Allouch-103/Abbes/report/main.pdf

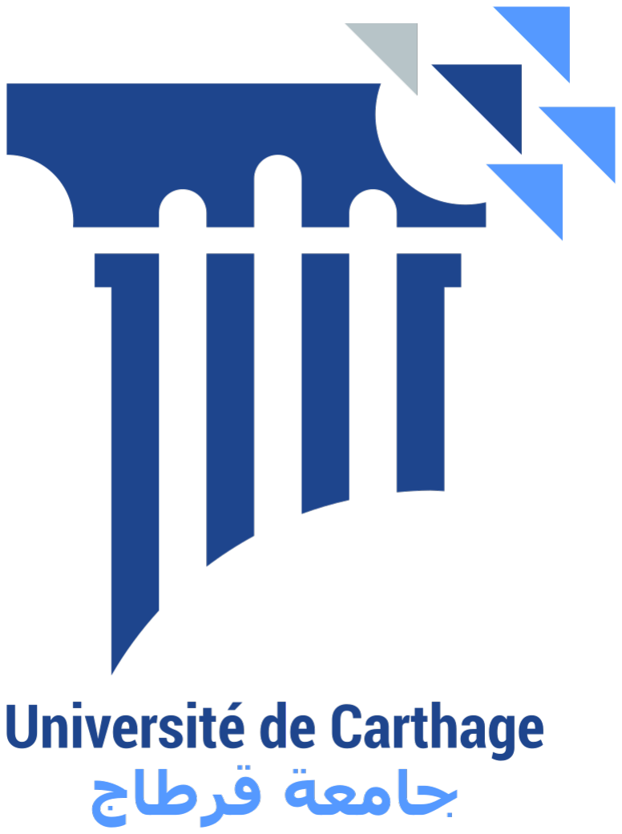
[picture p12: figure]
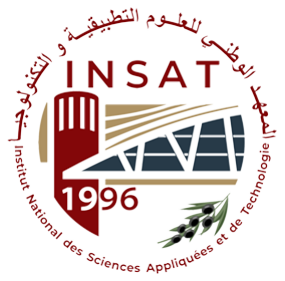
[picture p13: figure]

Ministry of Higher Education and Scientific Research
*** * ***
University of Carthage
*** * ***
National Institute
of Applied Science and
Technology

Projet Personnel Professionnel

Speciality: Software Engineering

Level: 3rd Year Engineering

Topic:

## Design and Software Architecture of an 18-DOF Humanoid Robot: ROS 2 Control, Simulation and an LLM-Based Natural-Language Command Layer

Prepared by:

### Zeyneb Benabdallah

### Yassine Allouch

Supervisor:

### Mme Hajer Taktak

Defended on 03/06/2026

### School Year: 2025 / 2026

# Acknowledgements

This work could not have been accomplished without the support and guidance of many people, to whom the authors wish to express their sincere gratitude.
The authors address their thanks first of all to their supervisor, Mme Hajer Taktak, for the trust she placed in them, for her guidance, her valuable advice and her availability throughout this project. Her insight greatly shaped both the technical direction and the quality of this work.
The authors also extend their gratitude to the members of the jury for the honour of agreeing to evaluate this project, as well as to the teaching staff of the National Institute of Applied Science and Technology (INSAT) for the knowledge shared throughout their studies.
Finally, the authors warmly thank their families and friends for their constant encouragement and unwavering support throughout this journey.

i

# Abstract

This report presents the design and software architecture of Abbes, a child-sized, 3D-printed humanoid robot with eighteen degrees of freedom (18-DOF). The platform is built end to end: from the mechanical CAD model and the electronics organised around an ESP32 micro-ros node, to a complete ROS 2 software stack that handles kinematics, balance and bipedal-gait generation. A Gazebo simulation provides a digital twin used for validation before deployment on the physical robot. Beyond the classical motioncontrol pipeline, the project introduces a high-level natural-language command layer: a locally hosted Large Language Model grounds free-form user instructions into a fixed, safety-checked command vocabulary that drives the robot’s actions. Particular emphasis is placed on the software engineering aspects of the system — the embedded firmware, the ROS 2 control architecture and the artificial-intelligence command pipeline — while the mechatronic and gait-planning foundations of the platform are also covered.

ii

# Contents

Acknowledgements | i
Abstract | ii
1 General Presentation and State of the Art | 1
2 Concepts on Bipedal Walking | 6
3 Hardware and Mechatronic Design | 11

iii

4 Embedded Firmware: the On-Board Controller | 17

iv

# List of Figures

1.1 WABIAN by Waseda | | 3
1.2 ASIMO | | 4
1.3 HRP humanoid robots | | 5
2.1 Motion planes: sagittal, horizontal, and frontal | | 7
2.2 General case of the ZMP: (a) three-dimensional case at the ankle, (b) planar case where the moment MAx is balanced by shifting the point of action of
the reaction force Rz | | 8
2.3 Support polygon in the single- and double-support phases | | 8

3.1 Anthropometric model: segment lengths as a proportion of total height H
(Winter’s model) | 12
3.2 Robot morphology: joint arrangement and reference frame (P: pitch, R:
roll, Y: yaw) | 13
3.3 Mechanical design of Abbes: (a) CAD model and (b) the 3D-printed, as-
sembled robot | 13
3.4 Electronic architecture of Abbes: the ESP32 micro-ROS node drives 18 servos through two PCA9685 boards and reads the MPU6050, communicating with the ROS 2 host over WiFi. Dashed red lines indicate power
distribution | 15

4.1 Firmware data paths: the command path (top) drives the servos at 100 Hz,
the sensing path (bottom) publishes the IMU at 50 Hz. Both periodic loops
run on the microcontroller’s clock | 18
4.2 micro-ROS bridges the microcontroller to the ROS 2 graph: a lightweight client on the ESP32 talks to an agent on the host, which connects it to the
full DDS network | 19
4.3 Agent-connection state machine, providing automatic reconnection without
rebooting the robot | 20

v

# List of Tables

1.1 Comparison of ASIMO Robot Models | | 3
1.2 Comparison of HRP Robot Models | | 4
1.3 Comparison of Bipedal Robots | | 5

3.1 Robot joint structure: axes, angular limits and resting positions (servo
degrees) | 14
3.2 Actuator specifications | 14
3.3 Sensor description | 15
3.4 Battery specifications | 15
3.5 Regulator specifications | 16

vi

# Chapter 1

# General Presentation and State of the Art

## 1.1 Introduction

Humanoid robotics is one of the most demanding fields of modern engineering: it combines mechanical design, real-time control, embedded electronics, and, increasingly, artificial intelligence into a single integrated system. Reproducing a behaviour as ordinary as human walking requires a machine to balance on a small support area while continuously coordinating many actuators, all under strict timing constraints. This makes a humanoid platform an ideal testbed for studying the interaction between low-level real-time control and high-level decision making.
This chapter introduces the project by outlining its objectives and its significance in the field of bipedal robotics. It then discusses the problematic aspects associated with bipedal walking, presents the state of the art through a few representative humanoid robots, and finally positions the Abbes robot — the platform developed in this work — with respect to those references. The objectives pursued are:
1. Design and assemble an 18-DOF humanoid structure from 3D-printed parts driven by hobby servo-motors.
2. Implement the on-board real-time firmware that actuates the joints and streams inertial measurements.
3. Build a modular ROS 2 software stack covering the kinematic model, balance control, and bipedal-gait generation.
4. Validate the robot in a physics-based simulation (digital twin) before deployment on hardware.
5. Add a natural-language command layer, based on a locally hosted Large Language Model, that translates free-form user requests into a fixed and safety-checked set of robot actions.

## 1.2 Problematic

Bipedal walking poses a unique set of challenges that stem from the need to maintain dynamic stability on two legs. For the platform developed here, these challenges are tightly coupled with the software-engineering goals of the project. The core problematic aspects are:

- Mechanical design. Defining a joint distribution that is rich enough to produce a stable, human-like gait while remaining buildable with low-cost, 3D-printed parts and hobby servo-motors.
- Control system. Despite the need for inverse kinematics in controlling a walking humanoid, ensuring robustness and adaptability in real-time control algorithms running on a resource-constrained microcontroller remains a significant challenge.
- Stability criteria. Keeping the robot balanced during the various phases of walking, which requires a recognised stability criterion and an inertial feedback loop.
- ROS 2 integration. Leveraging the advanced integration capabilities of ROS 2 to bridge a physics-based simulation and the physical robot through a common middleware.
- High-level interaction. Allowing a user to command the robot in natural language while guaranteeing that only safe, well-defined motions are ever executed.

## 1.3 State of the Art

Existing humanoid robots around the world showcase the remarkable advancements in robotics technology, demonstrating capabilities ranging from human-like motion and interaction to replacing humans in various industrial areas. The following sections review a few representative platforms.

### 1.3.1 WABIAN by Waseda

Since 1967, Waseda University has been at the forefront of biped-robot research. WABIAN-2 features 41 mechanical degrees of freedom, including two 6-DoF legs, a 2-DoF waist, a 2-DoF trunk, two 7-DoF arms, two 3-DoF hands, a 3-DoF neck, and two 1-DoF feet with passive toe joints. Standing at 1480 mm tall and weighing 64 kg, WABIAN-2 achieves a human-like gait characterised by stretched knees, heel-contact, and toe-off motion. This is made possible by its foot mechanism with passive toe joints and a 2-DoF (Roll, Yaw) waist that emulates human pelvic movement.

### 1.3.2 ASIMO by Honda

ASIMO is a research robot and is not available for commercial sale; it has, however, been loaned for unique events and used by major companies as a reception host. As of February 2009, there were over 100 ASIMO robots in various versions, ultimately aiming to assist individuals who are disabled, elderly, or ill, and to perform tasks that are dangerous for humans. The fifth version of ASIMO, released in September 2011, features enhanced capabilities including the use of all its fingers, equipped with tactile sensors in the palm and force detectors in each finger; combined with object-recognition technology, it can pick up a bottle and unscrew its cap, or hold a paper cup without crushing it. One of its main innovations is the ability to change direction smoothly while walking, without interrupting its stride.


Figure 1.1: WABIAN by Waseda.

Table 1.1: Comparison of ASIMO Robot Models.

Project | Date | Weight Length Anatomy | Functions | DoF DoF Head
P-1 | 1993–1997 175 kg | 1.915 m Head, Arm, Hand,
Leg, Feet, Trunk
Walking | – | –
P-2 | – | 210 kg | 1.82 m | – | Walking, Climbing
stairs
30 | –
P-3 | – | 52 kg | 1.2 m | – | Speed | walking
| | | | | (1.6 km/h)
26 | –
Asimo I | 2000 | 54 kg | 1.3 m | – | Speed | walking
| | | | | (3 km/h), | Object
| | | | | detection, | Face
| | | | | recognition
34 | 3
Asimo II | 2005 | 54 kg | 1.3 m | – | Running (6 km/h), Gripping objects
34 | 3
Asimo III 2011 | 48 kg | 1.3 m | – | Human daily tasks,
Collision | avoid-
ance, | Dynamic
| | | | | path planning
57 | 3

### 1.3.3 HRP Humanoid Series by AIST

The Humanoid Robotics Project (HRP) is an initiative aimed at developing general domestic-helper robots, funded by Japan’s Ministry of Economy, Trade and Industry (METI) and the New Energy and Industrial Technology Development Organization (NEDO). The project is led by Kawada Industries with support from the National Institute of Advanced Industrial Science and Technology (AIST) and Kawasaki Heavy Industries. The HRP series, also known as Promet, began with modifications to Honda’s P3 robots and includes features such as a tele-command system. Notably, HRP-2 can stand up after lying flat, a capability lacking in Honda’s ASIMO. The HRP-4, a bipedal humanoid, stands 150 cm tall and weighs 39 kg.

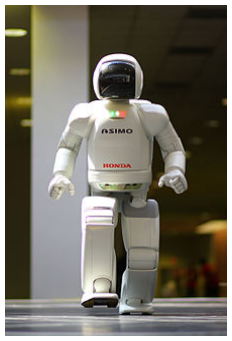
[picture p14: figure]

Figure 1.2: ASIMO.

Table 1.2: Comparison of HRP Robot Models.

Project Date Weight Length Anatomy | Functions | DoF DoF Head | DoF Arm | DoF Leg
HRP-1 | 1998 | 120 kg | 1.6 m | Head, | Trunk,
| | | | Arm, | Hand,
Leg, Feet
Walking | /
Hand | opera-
tions
30 | 2 | 14: 3 shoulders,
1 elbow, 3 wrist

12

HRP-2 | 2003 | 58 kg | 1.54 m | – | Walking on rug,
Standing, | Hu-
| | | | | man interaction
30 | 2 | 12: 3 shoulders,
1 elbow, 2 wrist

12

HRP-3 | 2007 | 65 kg | 1.6 m | – | Speed walking 2 km/h
42 | 2 | 12: 3 shoulders,
1 elbow, 2 wrist

12

HRP-4C 2009 | 43 kg | 1.58 m | – | Anthropomorphic,
Face | expres-
| | | | | sions
42 | 11: | 3 neck, 8
face
4 | 12
HRP-4 | 2010 | 39 kg | 1.51 m | – | Athleticism, Running, Oper- ating tasks
34 | 2 | 4 | 12

### 1.3.4 Positioning of Abbes

The platforms above achieve outstanding performance but rely on custom, expensive hardware that is out of reach for a student project. Abbes is positioned instead as a low-cost, fully 3D-printed, 18-DOF humanoid built around hobby servo-motors and an ESP32 microcontroller. Its distinguishing contribution is not raw locomotion performance but its software: a modern ROS 2 control stack with a physics-based digital twin, and a natural-language command layer driven by a locally hosted Large Language Model — a feature uncommon on platforms of this scale, and the main software-engineering contribution of this work.

## 1.4 Conclusion

This chapter explored the fundamental principles and obstacles within bipedal robotics. By examining both the challenges and the state-of-the-art developments, it identified the critical focal points for the project. The subsequent chapters delve into the specific methodologies, design considerations, and practical implementations required to build the robot. Table 1.3 provides a concise overview of the key features of the robots studied above.


(a) HRP-1 | (b) HRP-2

Figure 1.3: HRP humanoid robots.

Table 1.3: Comparison of Bipedal Robots.

Robot | Height (mm) Number of DoF | Capabilities and Features
WABIAN by Waseda | 1480 | 41 | Human-like gait, stretched knees, heel-contact, toe-off motion
ASIMO by Honda | Varies | Varies | Bipedal locomotion, object ma- nipulation, human interaction
HRP Series by AIST | Varies | Varies | Anthropomorphic design, various locomotion modes

# Chapter 2

# Concepts on Bipedal Walking

## 2.1 Introduction

Bipedal walking, or walking on two legs, is a complex form of locomotion that involves the coordination of multiple joints to achieve stability, balance, and forward motion. Understanding its principles is essential for designing and controlling a humanoid robot. This chapter introduces the fundamental concepts of bipedal walking: the definition of walking, the motion planes, the centre of mass, the Zero-Moment-Point, the support polygon, the stability criteria, the types of walking, and the gait cycle that together underpin the locomotion work presented later in this report.

## 2.2 Walking Definition

Walking can be defined as the action of moving by successive movements and support of the legs and feet without ever leaving the ground entirely. This definition does not constrain the number of limbs, so walking may be bipedal, quadrupedal, and so on; in this work the term refers to bipedal walking, since the objective is to reproduce human locomotion. Walking is therefore a cyclic phenomenon: each foot alternately swings through the air and then serves as support, either alone or together with the other foot. This cyclic nature is formalised through the notion of gait cycles and phases, developed in the following sections.

## 2.3 Motion Planes

The motion planes describe the movements associated with walking, as shown in Figure 2.1. The sagittal plane corresponds to a side view of the walker, the horizontal plane to a top view, and the frontal plane to a front view. The walker moves primarily in the sagittal plane, but movements such as hip sway, lateral displacement, and pelvic rotation occur in the other two planes and enhance the fluidity of walking.

## 2.4 Robot Control and Stability

Bipedal walking relies on several key concepts that ensure stability and efficiency. These concepts are essential for understanding how to design and control a bipedal robot.

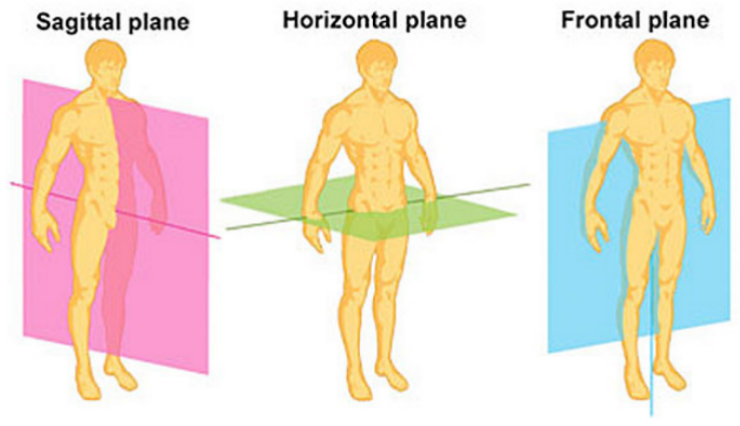
[picture p15: figure]

Figure 2.1: Motion planes: sagittal, horizontal, and frontal.

### 2.4.1 Centre of Mass (CoM)

The centre of mass (CoM), also known as the centre of gravity, is the point at which the mass of a body or system of bodies can be considered to be concentrated. For a rigid body, it is the point at which the body can be balanced without rotation under the influence of gravity alone. Mathematically, it is the weighted average of the positions of all the mass elements of the system. The CoM plays a central role in the study of the mechanics, dynamics, and stability of a walking robot.

### 2.4.2 Zero-Moment-Point (ZMP)

The Zero-Moment-Point (ZMP) is a criterion used to analyse the stability of a bipedal or multi-legged robot during dynamic motion. The ZMP is the point on the ground where the total moment of the forces acting on the robot’s feet has no horizontal component — that is, the point where the ground-reaction forces and the inertial forces acting on the robot’s body balance each other out.
Consider the support foot during the single-support phase (Figure 2.2). The effect of the parts above the support foot can be replaced by a force F and a moment MA at the ankle, while the ground reaction R and moment MS balance the system at the contact point S. Because the ground can only act on the foot through friction and a normal force, the horizontal moments vanish at this point — hence the term Zero-Moment-Point. The ZMP is thus the point under the foot where the ground reaction balances the horizontal moments applied at the ankle. To maintain dynamic balance, the ZMP must remain inside the support polygon; if the support area is too small to compensate the horizontal moment, the robot loses dynamic balance and the ZMP is no longer defined (a fictitious ZMP may then be computed for analysis).

### 2.4.3 Support Polygon

The support polygon is one of the stability criteria for humanoid walking. It is defined by the outer contour of the points of contact between the robot’s feet and the ground. As

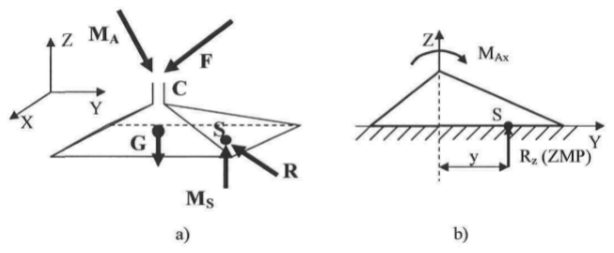
[picture p16: figure]

Figure 2.2: General case of the ZMP: (a) three-dimensional case at the ankle, (b) planar case where the moment MAx is balanced by shifting the point of action of the reaction force Rz.

illustrated in Figure 2.3, it takes two forms during the walking cycle: the single-support polygon, reduced to the contour of a single foot, and the larger double-support polygon, spanning both feet when they are simultaneously in contact with the ground.


Figure 2.3: Support polygon in the single- and double-support phases.

### 2.4.4 Stability Criteria

Two complementary aspects of stability are considered:
- Posture stability — the ability to maintain a stable standing position with minimal jerk. Joint positions and the centre of gravity are the main variables involved.
- Gait stability — the ability to maintain balance during locomotion. The key variables here are step length, foothold positions, and ZMP data.

## 2.5 Types of Bipedal Walking

Walking can be categorised into two types:

- Static walking. The posture is stable at all times: the body weight is always supported by at least one foot, and the projection of the CoM on the ground always remains within the support polygon.
- Dynamic walking. A succession of stable and unstable postures. Instability is deliberately created forward when the projection of the CoM moves outside the support polygon. Dynamic walking is the natural human gait; the resulting instability is corrected by the next step.

## 2.6 Robot Gait Generation

### 2.6.1 Walking-Cycle Components

Ignoring the very first and very last steps to and from a standing posture, the walking cycle is composed of two alternating phases:
Double-Support Phase (DSP) The robot is in contact with the floor through both legs. This phase lets the robot shift its ZMP into a favourable position for the next step without losing balance; it is therefore called the stabilisation phase.

Single-Support Phase (SSP) Also known as the swing phase, the robot is in contact with the floor through a single leg. The leg in contact is the support leg and the other is the swinging leg.

### 2.6.2 Walking-Cycle Phases

Within these components, the cycle progresses through the following phases:
- Impact / contact phase (DSP) — the heel of the front foot comes into contact with the floor.
- Lift-off / swing phase (SSP) — during the transition from double to single support, the swinging foot is lifted off the ground; the robot transfers its weight onto the support foot and starts swinging the rear leg forward.
- Catch phase (DSP) — the swinging foot comes back into contact with the floor, returning the robot to double support.
The roles of the two legs are then swapped and the cycle repeats.

### 2.6.3 Gait Engine

The gait engine, also referred to as the walking-pattern generator, is the software component responsible for producing a sequence of feasible joint positions that reproduce a walking motion. It accounts for the robot’s physical limitations, its preferred walking speed, and the desired gait style to compute the best sequence of joint angles and body motions for stable and efficient walking. Gait engines fall into two main families:
- ZMP-based approach — requires comprehensive knowledge of the robot’s parameters and uses the ZMP as a feedback signal to adjust joint angles and torques.
- Inverted-pendulum approach — operates with limited knowledge of the robot model and uses a closed-loop feedback based on the inverted-pendulum abstraction.

The gait generator developed in this work follows the ZMP-based approach and is detailed in Chapter ??.

## 2.7 Walking Primitive

A walking primitive is a fundamental building block that generates the motion of a robot’s gait. It defines characteristics such as step length, step height, and step frequency, taking into account the robot’s physical constraints, its stability requirements, and the desired locomotion behaviour.

## 2.8 Conclusion

This chapter introduced the fundamental concepts of bipedal walking, providing the vocabulary and the stability criteria — centre of mass, Zero-Moment-Point, and support polygon — that govern stable, human-like locomotion, together with the structure of the gait cycle. These concepts form the theoretical foundation for the hardware, firmware, and control chapters that follow. The next chapter presents the hardware and mechatronic design of the Abbes robot.

# Chapter 3

# Hardware and Mechatronic Design

## 3.1 Introduction

Designing a bipedal robot is a multidisciplinary task that combines principles from mechanical engineering, electronics, and computer science. This chapter presents the physical foundation of the Abbes robot: the mechanical design derived from human proportions, the selection of actuators and sensors, the power supply, and the electronic architecture built around an ESP32 microcontroller. Together these subsystems form the platform on which the firmware and control software of the following chapters run.

## 3.2 Mechanical Design

The mechanical design is inspired by the anatomical structure of the human body. As the review of existing humanoids in Chapter 1 showed, the construction of humanoid robots is rooted in mimicking human morphology.

### 3.2.1 Anthropometric Model

The anthropometric model expresses the robot’s dimensions as a function of human-body proportions, so that its segments and movements stay as close to human anatomy as possible. Anthropometry — from the Greek anthropos (human) and metron (measure) — is the study and measurement of the physical dimensions of the human body. This work relies on static anthropometric measurements, whose implementation is simpler, using the normalised segmental proportions established by Winter. Figure 3.1 gives the length of each limb relative to the total height H of the individual.

### 3.2.2 Mechanical Articulated Structure

The articulated structure is the set of interconnected joints and links that lets the robot reproduce human-like movements. The number of degrees of freedom (DOF) must be large enough for agility and balance, yet kept minimal to simplify the model. For a leg, two DOF (at the hip and ankle) enable pendulum-like motion in the sagittal plane, and two more provide lateral motion in the frontal plane; a fifth DOF at the knee is required to clear the foot during the swing phase. This leads to five DOF per leg. Each arm uses three DOF, and the head two, as detailed in the next section. Figure 3.2 shows the resulting joint arrangement.


Figure 3.1: Anthropometric model: segment lengths as a proportion of total height H (Winter’s model).

### 3.2.3 Final Design: Joint Limits and Resting Positions

The final design is an 18-DOF humanoid with the following distribution:
- Each leg — 5 DOF: 2 at the hip (pitch and roll), 1 at the knee (pitch), and 2 at the ankle (pitch and roll).
- Each arm — 3 DOF: 2 at the shoulder (pitch and roll) and 1 at the elbow (roll).
- Head — 2 DOF: head yaw and camera pitch.
Table 3.1 summarises the complete joint structure. The angle range and resting position of each joint are expressed in degrees of servo travel; these exact values are the single source of truth used by the firmware (the limits are enforced before any command reaches a servo, see Chapter 4). The joints are listed in the firmware’s index order, which groups the right-side joints and the head on the first PWM board and the left-side joints on the second.
The mechanical parts are designed in CAD (Figure 3.3a) and manufactured by 3D printing; the assembled robot is shown in Figure 3.3b.

## 3.3 Hardware Components

### 3.3.1 Actuators

Selecting actuators involves several criteria: high torque and precision for accurate motion, efficient current consumption, a size and weight compatible with the structure, durability, and cost. Table 3.2 compares the candidates considered. The MG996R servo was selected: it offers a sufficient torque-to-cost ratio for a child-sized, 3D-printed platform,


Figure 3.2: Robot morphology: joint arrangement and reference frame (P: pitch, R: roll, Y: yaw).


(a) CAD model | (b) Assembled robot

Figure 3.3: Mechanical design of Abbes: (a) CAD model and (b) the 3D-printed, assembled robot.

and it is directly compatible with standard PWM control. The robot uses eighteen such servos, one per joint.

### 3.3.2 Sensors

The robot’s primary sensor is the MPU6050, which combines a three-axis gyroscope and a three-axis accelerometer in a single low-cost, I²C-compatible package (Table 3.3). It provides the angular-velocity and acceleration data needed to estimate the robot’s orientation and to maintain balance during motion. Its digital interface simplifies integration with the microcontroller.

Table 3.1: Robot joint structure: axes, angular limits and resting positions (servo degrees).

# | Joint name | Axis | Min (◦

) Max (◦

) Rest (◦
)
1 | r_shoulder_pitch | pitch | 0 | 180 | 90
2 | r_shoulder_roll | roll | 0 | 180 | 90
3 | r_elbow_roll | roll | 0 | 180 | 90
4 | head_yaw | yaw | 0 | 180 | 90
5 | camera_pitch | pitch | 0 | 180 | 90
6 | r_hip_roll | roll | 0 | 170 | 50
7 | r_hip_pitch | pitch | 0 | 170 | 80
8 | r_knee_pitch | pitch | 0 | 170 | 100
9 | r_ankle_pitch | pitch | 10 | 180 | 100
10 | r_ankle_roll | roll | 20 | 150 | 90
11 | l_shoulder_pitch | pitch | 0 | 180 | 90
12 | l_shoulder_roll | roll | 0 | 180 | 90
13 | l_elbow_roll | roll | 0 | 180 | 90
14 | l_hip_roll | roll | 0 | 170 | 50
15 | l_hip_pitch | pitch | 0 | 170 | 80
16 | l_knee_pitch | pitch | 0 | 170 | 70
17 | l_ankle_pitch | pitch | 10 | 180 | 90
18 | l_ankle_roll | roll | 20 | 150 | 90

Table 3.2: Actuator specifications.

Actuator | Model | Price (€) Torque (kg·cm) Position sensor | Current (A)
Servo | MG996R | 20 | 10 | – | 1
Dynamixel | MX-28 | 312 | 31.6 | Contactless | 1.7
Servo | HS-645MG | 38.40 | 107 / 133 | – | 2.5

### 3.3.3 Power Supply

The power supply must deliver the voltage and current required by all components within budget constraints. The robot is currently powered from an off-board source; a batterypowered version is planned as future work. Table 3.4 lists the battery options selected for that version: a high-capacity LiPo pack is preferred for its current rating, at a higher cost than a basic lithium cell.

### 3.3.4 DC/DC Regulator

A DC/DC converter adapts the battery voltage to the levels required by the servos and the electronics. Table 3.5 compares the regulators considered, trading current rating against cost.

Table 3.3: Sensor description.

Sensor | Description
MPU6050 | Combines a three-axis gyroscope and a three-axis ac-
celerometer (raw I²C).

Table 3.4: Battery specifications.

Battery | Current rating (mAh) Cost
LiPo | 5000 | High
Lithium | 1000 | Low

## 3.4 Electronic Architecture

The robot’s electronics are organised into a control section and a power section. The control section is built around an ESP32 microcontroller, which runs the real-time control loop directly on the robot and joins the ROS 2 graph as a micro-ROS node over WiFi/UDP. The ESP32 drives the eighteen servos through two PCA9685 16-channel PWM driver boards on the I²C bus (at addresses 0x40 and 0x41): the first board carries the right-side and head joints, the second the left-side joints. The same I²C bus connects the MPU6050 IMU. On the host (laptop) side, a micro-ROS agent bridges the ESP32 into ROS 2, so that the inertial data published by the node and the joint commands it receives are available as ordinary ROS 2 topics. This architecture replaces the more common pairing of a single-board computer with a separate servo controller by a single, low-cost microcontroller that communicates wirelessly. The power section supplies the servos and electronics through the battery and DC/DC regulator described above. Figure 3.4 summarises the architecture.

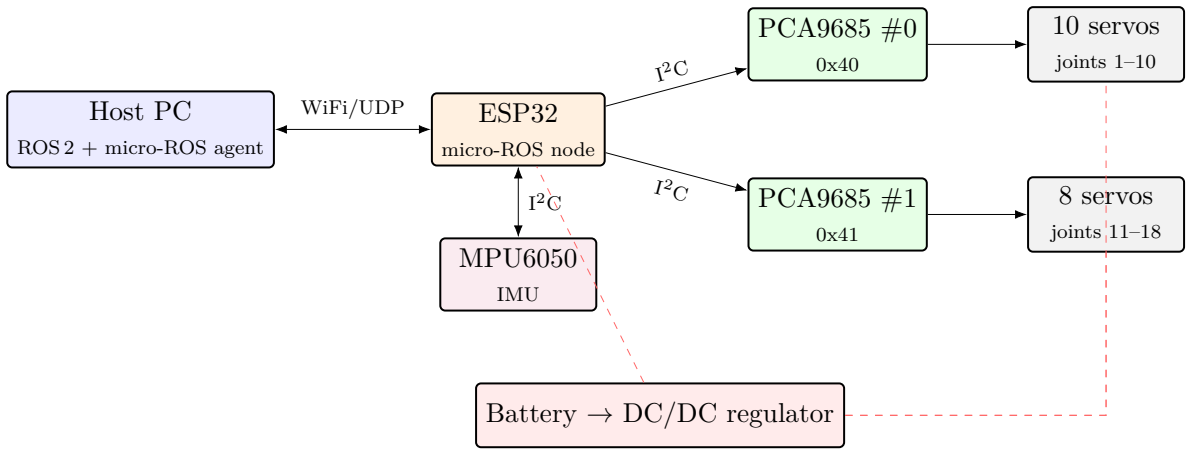
[picture p17: figure]
Host PC; ROS 2 + micro-ROS agent; ESP32; micro-ROS node; PCA9685 #0; PCA9685 #1; MPU6050; IMU; 10 servos; joints 1–10; 8 servos; joints; Battery → DC/DC regulator; WiFi/UDP

Figure 3.4: Electronic architecture of Abbes: the ESP32 micro-ROS node drives 18 servos through two PCA9685 boards and reads the MPU6050, communicating with the ROS 2 host over WiFi. Dashed red lines indicate power distribution.

Table 3.5: Regulator specifications.

Regulator | Current rating (A) Cost (€)
XL6009 | 3.0 | 14
XL4016 | 9.0 | 30
LM2596 | 1.5 | 8

## 3.5 Conclusion

This chapter presented the hardware foundation of Abbes. The mechanical structure was derived from anthropometric data to obtain a human-like, 18-DOF morphology, and its joint limits were defined (Table 3.1). The components were selected to balance performance, cost, and efficiency: MG996R servos, an MPU6050 IMU, and a battery/regulator pair for the powered version. The electronic architecture is built around an ESP32 that drives the servos through two PCA9685 boards and joins ROS 2 as a micro-ROS node. The next chapter details the embedded firmware that runs on this ESP32.

# Chapter 4

# Embedded Firmware: the On-Board Controller

## 4.1 Introduction

The firmware is the lowest software layer of the robot: it runs directly on the microcontroller introduced in Chapter 3 and turns the electronics into an active component of the robot’s software system. Its responsibilities are concrete: receive the eighteen target joint angles, drive the servos smoothly through the two PCA9685 boards, read the MPU6050 inertial sensor, and make all of this available to the rest of the system. This chapter first justifies the choice of the ESP32, then explains how the firmware is organised, how it handles the actuators and sensors over the I²C bus, and finally how it joins the ROS 2 world through micro-ROS — the bridge that leads naturally into the next chapter.

## 4.2 Choice of the ESP32

The on-board controller has a demanding but bounded role: it must update eighteen servos and sample an inertial sensor at a steady rate, while exchanging data with the host computer. Selecting a microcontroller for this task involves balancing computing power, connectivity, and cost.
The ESP32 was chosen because it meets all of these constraints at once. It is a low-cost, dual-core processor running at 240 MHz with enough memory to host a lightweight ROS 2 client, which is far beyond the reach of an 8-bit board such as a basic Arduino. Crucially, it integrates WiFi, allowing the robot to communicate with the host wirelessly and to operate untethered. It natively supports the I

2C bus required by both
the PCA9685 PWM drivers and the MPU6050 sensor, and it runs a real-time operating system (FreeRTOS) whose two cores can separate time-critical communication from supervision. Finally, it is well supported by the embedded ROS 2 tooling used in this project. Compared with a single-board computer such as a Raspberry Pi, the ESP32 is cheaper, lighter, and consumes far less power — and the modest computation performed on board does not require a full operating system, making the single-board computer unnecessary for this layer.

## 4.3 Firmware Architecture

The firmware is written in C++ on the Arduino/PlatformIO framework and is deliberately split into focused modules rather than a single monolithic program: one module manages the servos, one is a self-contained driver for the IMU, and one handles the communication with the host. A separate file holds the joint map (Table 3.1) and all hardware constants, so that no hardware-specific value is hidden in the logic.
The architecture takes advantage of the ESP32’s two cores. All communication — the wireless link, the connection lifecycle, and the dispatching of incoming and outgoing messages — runs in a dedicated real-time task pinned to core 1. Core 0 is left to the main program, which only supervises the system and is reserved for future watchdog and safety logic. Separating communication from supervision in this way ensures that activity on the network cannot stall the safety logic, and vice versa.
Functionally, the firmware implements two continuous data paths, shown in Figure 4.1. On the command path, target joint angles arriving from the host are stored, and a periodic 100 Hz routine drives the servos toward those targets through the PWM boards. On the sensing path, the inertial sensor is sampled and a periodic 50 Hz routine sends the measurements back to the host. Both periodic routines are driven by the microcontroller’s own clock, so the joint-control rate remains regular even when network traffic is not. On start-up, the same servo mechanism first brings all joints smoothly to their resting position before any command is accepted.

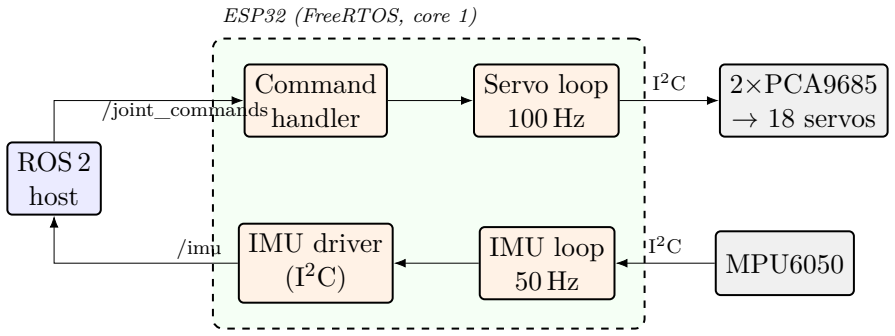
[picture p18: figure]
ESP32 (FreeRTOS, core 1); ROS 2 host; Command handler; Servo loop 100 Hz; IMU driver (I²C); IMU loop 50 Hz; 2×PCA9685 → 18 servos; MPU6050; /joint_commands; /imu

Figure 4.1: Firmware data paths: the command path (top) drives the servos at 100 Hz, the sensing path (bottom) publishes the IMU at 50 Hz. Both periodic loops run on the microcontroller’s clock.

## 4.4 Actuators and Sensors over I²C

The PWM driver boards and the inertial sensor all share a single I

2C bus, a two-wire
serial bus on which each device has its own address. This is what allows three peripherals — the two PCA9685 boards (at addresses 0x40 and 0x41) and the MPU6050 — to be controlled through only two microcontroller pins.

Actuators. A joint angle cannot be sent to a servo directly; it must be expressed as the width of a PWM pulse. The firmware converts each angle in degrees to the corresponding pulse width for the MG996R servos and sends it to the appropriate PCA9685 channel. Two safeguards are applied in the process. First, every command is clamped to the individual angular limits of the joint (Table 3.1) before it reaches a servo, so an out-of-range request can never force a joint past its mechanical limit. Second, and most importantly, the servos are never commanded to jump straight to a new target: the target is only stored, and the 100 Hz loop moves each joint toward it by a small, fixed maximum step on every tick — a velocity-limited interpolation. This ramps every motion smoothly and protects the plastic gears of the hobby servos from the abrupt slams that a sudden set-point would otherwise cause.

Sensor. The MPU6050 combines a three-axis accelerometer and a three-axis gyroscope, and is read over the same I²C bus through a self-contained driver rather than a thirdparty library, keeping the behaviour fully under control. At start-up the driver wakes the sensor, enables a low-pass filter to reject vibration noise, and sets the measurement ranges and sampling rate. Each reading then retrieves all of the acceleration and angular-velocity data in a single bus transaction, which guarantees that every axis belongs to the same sample, and converts the raw values into physical units. Importantly, the firmware performs no orientation estimation on the device: it transmits acceleration and angular velocity only. Fusing those two signals into a usable tilt estimate is left to a node on the host side (Chapter ??), which keeps the microcontroller’s workload light and places the filtering logic where it is easiest to tune.

## 4.5 Joining ROS 2 with micro-ROS

The two data paths described above must ultimately connect to the rest of the system. The entire software stack of Abbes is built on ROS 2 — the simulation, the controllers, and the artificial-intelligence layer of the following chapters all communicate through it. ROS 2, however, is designed to run on full computers: its communication relies on the DDS middleware, whose memory and processing requirements far exceed what a microcontroller can provide. Keeping the ESP32 outside ROS 2 and talking to it over a custom serial protocol would mean hand-written message framing on both sides, no introspection, and brittle, hard-to-extend code.
micro-ROS resolves this. It brings the ROS 2 client concepts — nodes, topics, publishers and subscribers — to microcontrollers running a real-time operating system. In place of the full DDS middleware it uses a lightweight client that communicates with a companion process on the host, the micro-ROS agent; the agent translates the compact messages from the microcontroller into the full ROS 2 traffic, and back (Figure 4.2). From the point of view of the rest of the system, the ESP32 then appears as an ordinary ROS 2 node: its data can be inspected with the same tools and uses the same standard message types as any other node.

ESP32

micro-ROS client

micro-ROS agent

(host)

ROS 2 graph

controllers, sim, AI

WiFi/UDP | DDS

Figure 4.2: micro-ROS bridges the microcontroller to the ROS 2 graph: a lightweight client on the ESP32 talks to an agent on the host, which connects it to the full DDS network.

This is exactly why micro-ROS is convenient here: the on-robot controller speaks the same language as everything else, so the inertial data and the joint commands are exposed as standard ROS 2 topics, with no custom protocol or translation glue to maintain. Concretely, the firmware advertises a node that subscribes to the joint-command topic and publishes the IMU topic. Both use best-effort delivery: for a continuous stream of set-points and inertial samples, the newest value always supersedes the previous one, so re-transmitting a lost message would only add latency.
Because the wireless link can drop, the firmware tolerates an agent that comes and goes through the explicit state machine of Figure 4.3. It waits for the network, then for the agent; once the agent answers it creates the ROS 2 entities and enters the connected state, where it periodically re-checks the link. If the agent is lost, the node cleanly destroys its entities and returns to waiting — so the robot reconnects automatically, without a reboot. An on-board LED mirrors this state, lit only while connected.

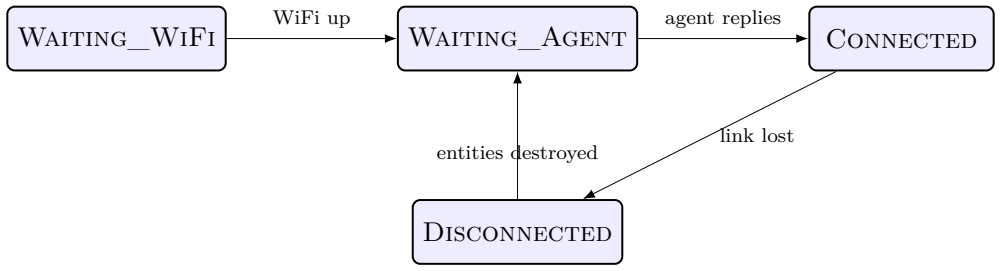
[picture p19: figure]
Waiting_WiFi; Waiting_Agent; Connected; Disconnected; WiFi up; agent replies; link lost; entities destroyed

Figure 4.3: Agent-connection state machine, providing automatic reconnection without rebooting the robot.

## 4.6 Conclusion

This chapter described the embedded firmware of Abbes. The ESP32 was chosen for its dual-core processing, integrated WiFi, native I²C support, and low cost. Around it, the firmware is organised into focused modules running two periodic data paths — a 100 Hz servo loop and a 50 Hz sensing loop — with per-joint limiting and velocity-limited interpolation to protect the hardware. The actuators and the inertial sensor share a single I

2C bus, and the node joins the rest of the system through micro-ROS, which makes the microcontroller a first-class participant in the ROS 2 graph. That graph — the host-side software architecture that produces the joint commands and consumes the inertial data — is the subject of the next chapter.
