Allouch-103/Abbes/report/frontmatter/cover.tex

  %=====================================================================
%  Cover page  (layout modelled on the reference PFA cover)
%=====================================================================
\begin{titlepage}
\centering

%--------------------- Top header: logos + institution --------------
\noindent
\begin{minipage}[c]{0.25\textwidth}
  \centering
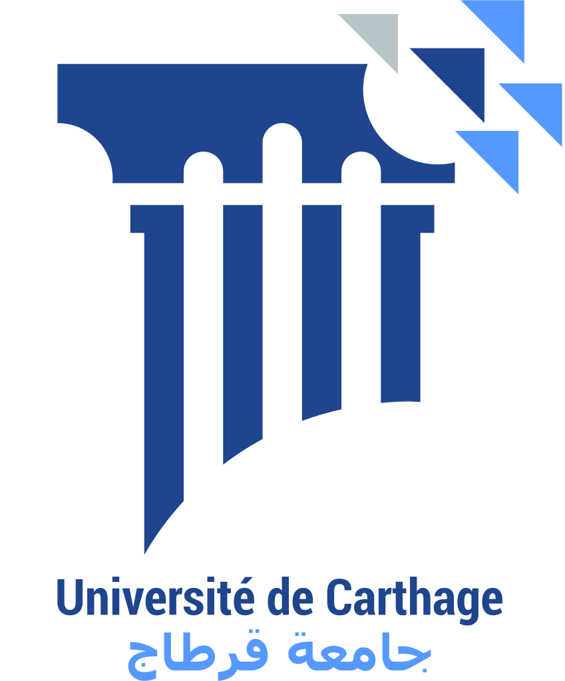
[picture p25: report/figures/logo_carthage.png]
  
\end{minipage}%
\hfill
\begin{minipage}[c]{0.46\textwidth}
  \centering
  Ministry of Higher Education\\
  and Scientific Research\\
  *** * ***\\
  University of Carthage\\
  *** * ***\\
  \textbf{National Institute\\
  of Applied Science and\\
  Technology}
\end{minipage}%
\hfill
\begin{minipage}[c]{0.22\textwidth}
  \centering
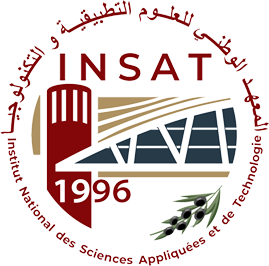
[picture p26: report/figures/logo_insat.png]
  
\end{minipage}

\vspace{0.6em}
\noindent\rule{\textwidth}{0.8pt}

%--------------------- Project type / speciality / level ------------
\vspace{2.2em}
{\scshape\LARGE \projType\par}
\vspace{1.6em}
{\scshape\Large Speciality: \projSpeciality\par}
\vspace{1.0em}
{\scshape\Large Level: \projLevel\par}
\vspace{2.2em}

\noindent\rule{\textwidth}{0.8pt}

%--------------------- Topic / title --------------------------------
\vspace{1.6em}
{\uline{\textbf{Topic:}}\par}
\vspace{1.2em}
{\bfseries\Large \projTitle\par}
\vspace{1.6em}

\noindent\rule{\textwidth}{0.8pt}

%--------------------- Author / supervisor --------------------------
\vspace{2.6em}
{\itshape Prepared by:\par}
\vspace{0.4em}
{\bfseries\itshape\large \projAuthorA\par}
\vspace{0.3em}
{\bfseries\itshape\large \projAuthorB\par}

\vspace{1.8em}
{\itshape Supervisor:\par}
\vspace{0.4em}
{\bfseries\itshape\large \projSupervisor\par}

\vspace{1.8em}
{\itshape\small Defended on \projDefDate\par}

\vspace{1.4em}
{\large School Year: \projYear\par}

\vfill
\end{titlepage}
