Allouch-103/Abbes/ros2_ws/src/my_robot_description/meshes/NewmainBodyback.SLDPRT.STL

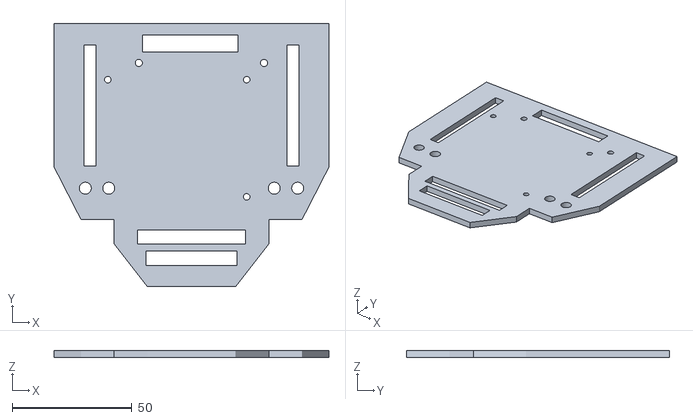
[picture p27: CAD file, 2026-05-26]
ros2_ws/src/my_robot_description/meshes/NewmainBodyback.SLDPRT.STL
115.0 x 110.0 x 3.00
