Allouch-103/Abbes/ros2_ws/src/my_robot_description/meshes/Newleg bracket.STL

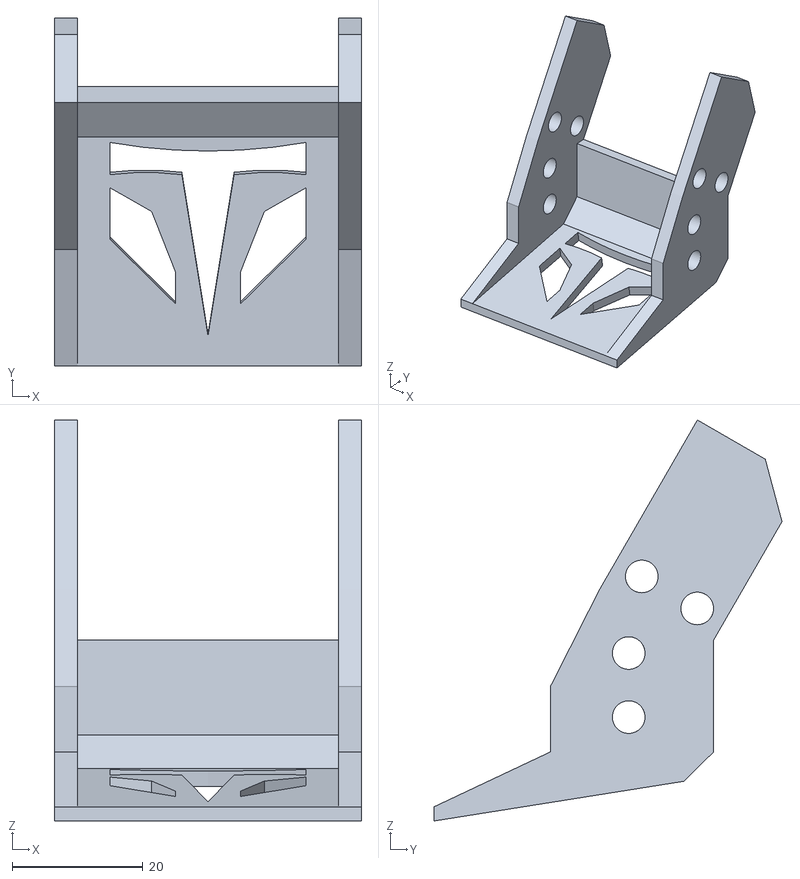
[picture p28: CAD file, 2026-05-26]
ros2_ws/src/my_robot_description/meshes/Newleg bracket.STL
47.0 x 53.3 x 61.4
