Allouch-103/Abbes/ros2_ws/src/my_robot_description/meshes/Pièce21.STL

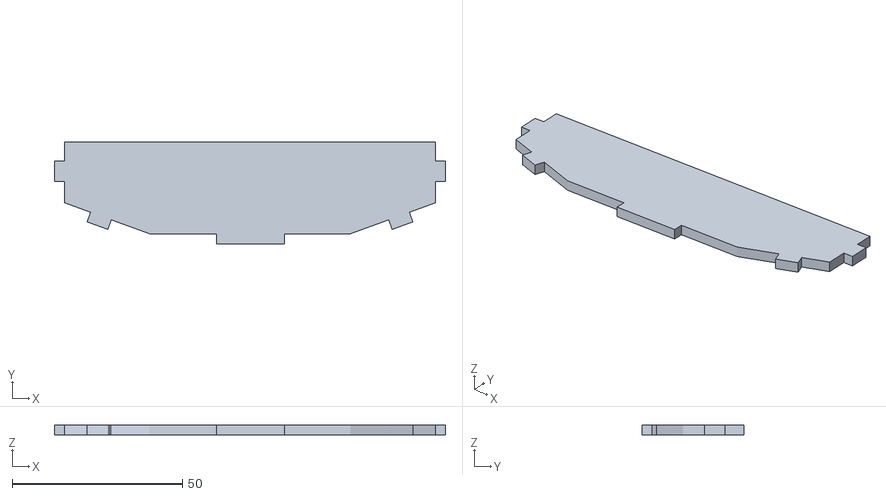
[picture p29: CAD file, 2026-05-26]
ros2_ws/src/my_robot_description/meshes/Pièce21.STL
115.0 x 30.0 x 3.00
