Allouch-103/Abbes/ros2_ws/src/my_robot_description/meshes/NewL.STL

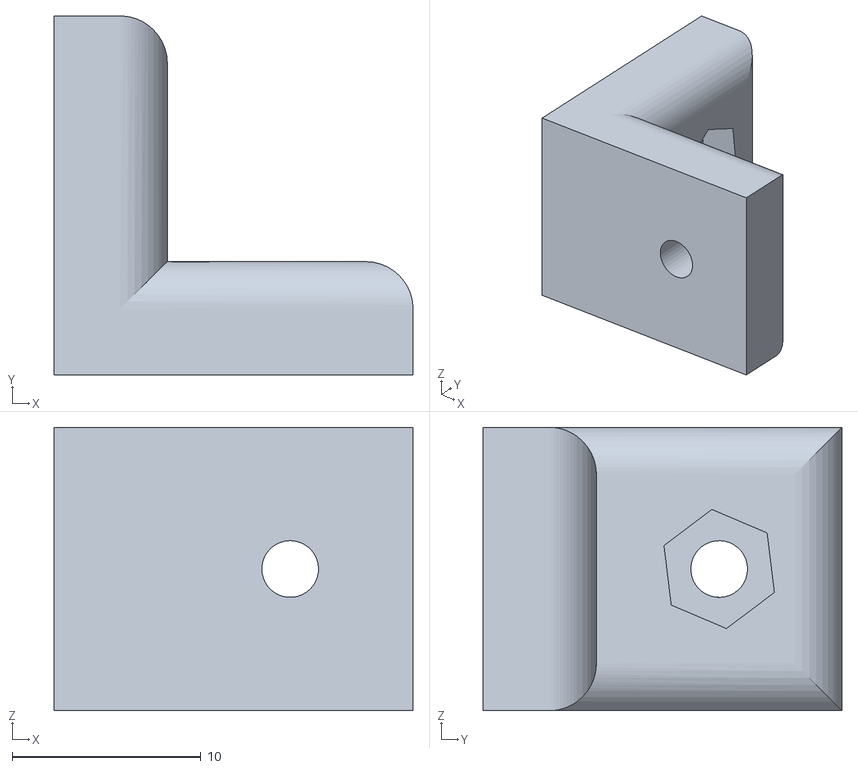
[picture p30: CAD file, 2026-05-26]
ros2_ws/src/my_robot_description/meshes/NewL.STL
19.0 x 19.0 x 15.0
