Allouch-103/Abbes/ros2_ws/src/my_robot_description/meshes/Newfoot.SLDPRT.STL

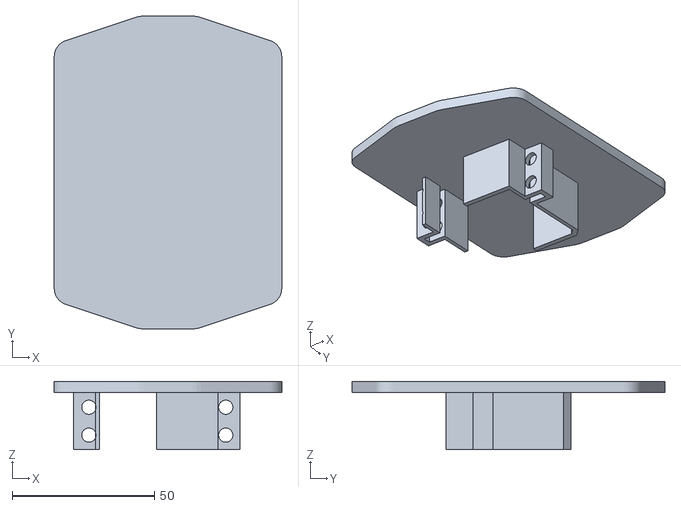
[picture p31: CAD file, 2026-05-26]
ros2_ws/src/my_robot_description/meshes/Newfoot.SLDPRT.STL
80.0 x 110.0 x 24.0
