Allouch-103/Abbes/ros2_ws/src/my_robot_description/meshes/Symétrie_Arm_Newsecond link.STL

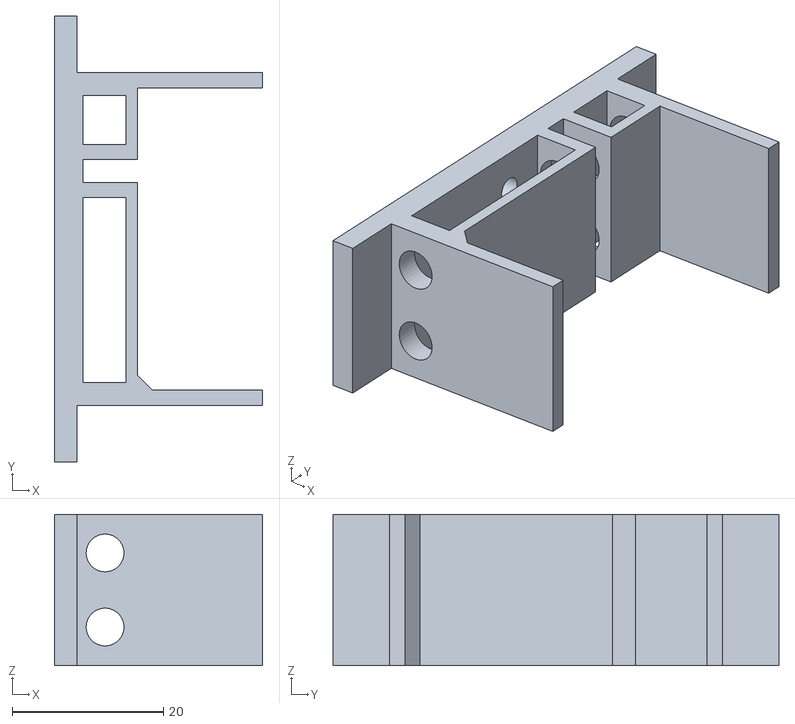
[picture p32: CAD file, 2026-05-26]
ros2_ws/src/my_robot_description/meshes/Symétrie_Arm_Newsecond link.STL
27.5 x 59.0 x 20.0
