Allouch-103/Abbes/ros2_ws/src/my_robot_description/meshes/Newnew_support.STL

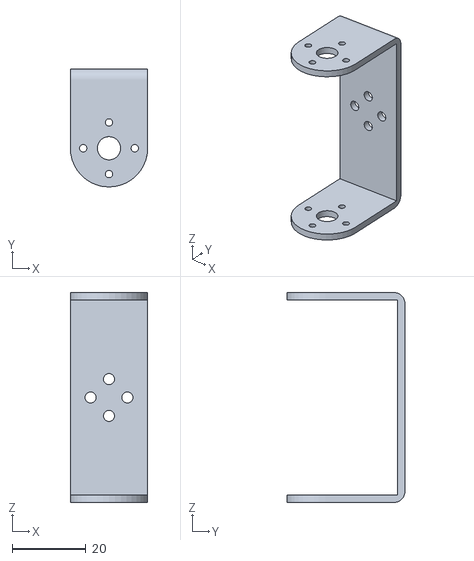
[picture p33: CAD file, 2026-05-26]
ros2_ws/src/my_robot_description/meshes/Newnew_support.STL
21.0 x 32.0 x 57.0
