Allouch-103/Abbes/ros2_ws/src/my_robot_description/meshes/NewPièce226.STL

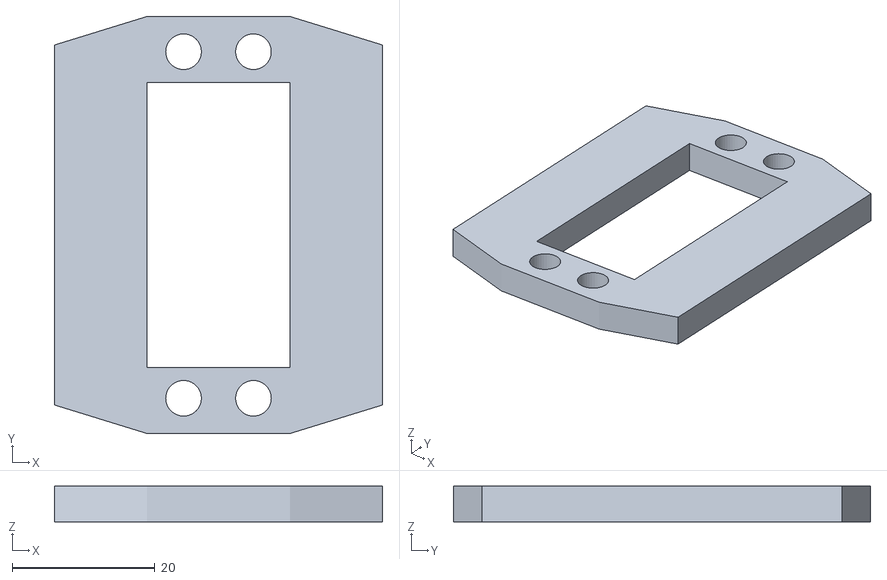
[picture p34: CAD file, 2026-05-26]
ros2_ws/src/my_robot_description/meshes/NewPièce226.STL
46.0 x 58.5 x 5.00
