Allouch-103/Abbes/ros2_ws/src/my_robot_description/meshes/TowerPro_MG946R.STL

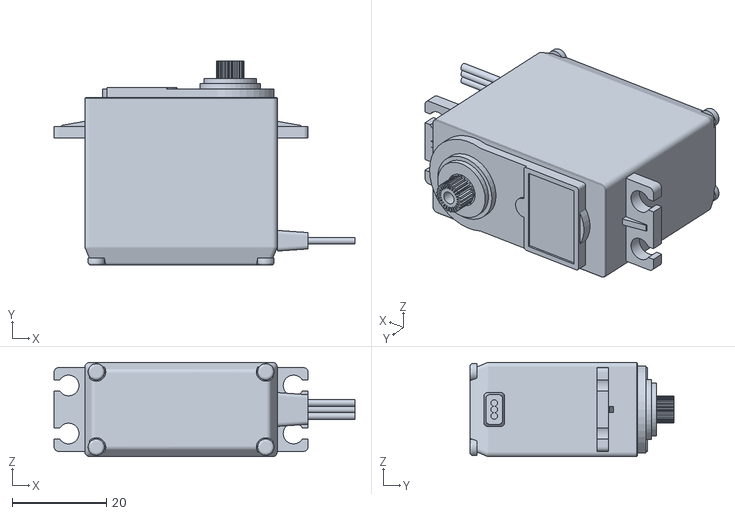
[picture p35: CAD file, 2026-05-26]
ros2_ws/src/my_robot_description/meshes/TowerPro_MG946R.STL
64.0 x 43.4 x 20.0
