Allouch-103/Abbes/(list of files, cad)

Other CAD files:
ros2_ws/src/my_robot_description/meshes/NewmainBodyfront.STL
ros2_ws/src/my_robot_description/meshes/supportnewfoot.STL
ros2_ws/src/my_robot_description/meshes/Newsecond link.STL
ros2_ws/src/my_robot_description/meshes/servo_cheville_connection.STL
