Allouch-103/Abbes/ros2_ws/src/humanoid_robot/config/ik_params.yaml

# Parameters for inverse_kinematics (legacy)
inverse_kinematics:
  ros__parameters:
    L1: 0.1225
    L2: 0.1230
    hip_width: 0.0800
    com_height: 0.2698
    knee_min_deg: 5.0
    enabled: true

# Parameters for ik_vectors_DLS (active IK node)
ik_vectors_dls:
  ros__parameters:
    L1: 0.1225
    L2: 0.1230
    hip_width: 0.0800
    com_height: 0.2698
    alpha: 0.01
    alpha_max: 0.15
    w_thresh: 0.005
    max_iter: 6
    tol: 0.001
    enabled: true
