Allouch-103/Abbes/ros2_ws/src/humanoid_robot/src/ik_vectors_DLS.cpp

// ============================================================================
//  ik_vectors_DLS.cpp
//  ROS2 node — Wampler 1986 DLS-IK. All math lives in wampler_leg.hpp.
//
//  Subscribed:
//    /com_trajectory   (geometry_msgs/PoseStamped)  100 Hz  best_effort
//    /foot_trajectory  (geometry_msgs/PoseArray)    100 Hz  best_effort
//  Published:
//    /joint_commands   (std_msgs/Float32MultiArray[18], degrees)  100 Hz
// ============================================================================

#include <rclcpp/rclcpp.hpp>
#include <geometry_msgs/msg/pose_stamped.hpp>
#include <geometry_msgs/msg/pose_array.hpp>
#include <std_msgs/msg/float32_multi_array.hpp>
#include <rcl_interfaces/msg/set_parameters_result.hpp>

#include "humanoid_robot/wampler_leg.hpp"
#include "humanoid_robot/joint_table.hpp"

#include <cmath>
#include <array>

class IKVectorsDLS : public rclcpp::Node
{
public:
    IKVectorsDLS() : Node("ik_vectors_dls")
    {
        declare_parameter("L1",          0.1225);
        declare_parameter("L2",          0.1230);
        declare_parameter("hip_width",   0.0800);
        declare_parameter("com_height",  0.30);
        declare_parameter("enabled",     true);
        declare_parameter("alpha",       0.01);
        declare_parameter("alpha_max",   0.15);
        declare_parameter("w_thresh",    0.005);
        declare_parameter("max_iter",    6);
        declare_parameter("tol",         0.001);

        load_params();

        joint_pub_ = create_publisher<std_msgs::msg::Float32MultiArray>(
            "/joint_commands", rclcpp::QoS(1).best_effort());

        auto qos = rclcpp::QoS(1).best_effort();
        com_sub_ = create_subscription<geometry_msgs::msg::PoseStamped>(
            "/com_trajectory", qos,
            [this](geometry_msgs::msg::PoseStamped::SharedPtr m) {
                com_x_ = m->pose.position.x;
                com_y_ = m->pose.position.y;
                com_z_ = m->pose.position.z;
            });
        foot_sub_ = create_subscription<geometry_msgs::msg::PoseArray>(
            "/foot_trajectory", qos,
            [this](geometry_msgs::msg::PoseArray::SharedPtr m) {
                if (m->poses.size() >= 2) {
                    fr_ = {m->poses[0].position.x, m->poses[0].position.y, m->poses[0].position.z};
                    fl_ = {m->poses[1].position.x, m->poses[1].position.y, m->poses[1].position.z};
                }
            });

        timer_ = create_wall_timer(std::chrono::milliseconds(10),
            [this]() { tick(); });

        param_cb_ = add_on_set_parameters_callback(
            [this](const std::vector<rclcpp::Parameter>& /*params*/)
                -> rcl_interfaces::msg::SetParametersResult {
                load_params();
                rcl_interfaces::msg::SetParametersResult r;
                r.successful = true;
                return r;
            });

        reset_to_rest();

        RCLCPP_INFO(get_logger(),
            "DLS-IK node ready | L1=%.4f L2=%.4f hip=%.4f α=%.4f α_max=%.3f",
            L1_, L2_, hip_width_, leg_r_.alpha, leg_r_.alpha_max);
    }

private:
    double L1_, L2_, hip_width_, com_height_, torso_height_, foot_height_;
    WamplerLeg leg_r_, leg_l_;

    double com_x_{0}, com_y_{0}, com_z_{0};
    Vec3   fr_{}, fl_{};

    rclcpp::Publisher<std_msgs::msg::Float32MultiArray>::SharedPtr joint_pub_;
    rclcpp::Subscription<geometry_msgs::msg::PoseStamped>::SharedPtr com_sub_;
    rclcpp::Subscription<geometry_msgs::msg::PoseArray>::SharedPtr  foot_sub_;
    rclcpp::TimerBase::SharedPtr timer_;
    rclcpp::node_interfaces::OnSetParametersCallbackHandle::SharedPtr param_cb_;

    static constexpr double D2R = M_PI / 180.0;
    static constexpr Vec5 Q_LO = {-50*D2R, -80*D2R,  -5*D2R, -90*D2R, -70*D2R};
    static constexpr Vec5 Q_HI = {120*D2R,  90*D2R, 100*D2R,  80*D2R,  60*D2R};

    void load_params()
    {
        L1_         = get_parameter("L1").as_double();
        L2_         = get_parameter("L2").as_double();
        hip_width_  = get_parameter("hip_width").as_double();
        com_height_ = get_parameter("com_height").as_double();
        torso_height_ = get_parameter("torso_height").as_double();  // ADD
        foot_height_  = get_parameter("foot_height").as_double();
        for (auto* leg : {&leg_r_, &leg_l_}) {
            leg->L1        = L1_;
            leg->L2        = L2_;
            leg->alpha     = get_parameter("alpha").as_double();
            leg->alpha_max = get_parameter("alpha_max").as_double();
            leg->w_thresh  = get_parameter("w_thresh").as_double();
            leg->max_iter  = static_cast<int>(get_parameter("max_iter").as_int());
            leg->tol       = get_parameter("tol").as_double();
        }
    }

    void reset_to_rest()
    {
        for (auto* leg : {&leg_r_, &leg_l_})
            leg->q = {0.0, 15*D2R, 30*D2R, -45*D2R, 0.0};
        com_x_=0; com_y_=0; com_z_=com_height_;
        fr_ = {0,  hip_width_/2.0, foot_height_};
        fl_ = {0, -hip_width_/2.0, foot_height_};
    }

    void apply_right(std::array<float,18>& a) const
    {
        constexpr double R2D = 180.0/M_PI;
        const Vec5& q = leg_r_.q;
        a[J::R_HIP_ROLL]    = clamp_joint(J::R_HIP_ROLL,    q[0]*R2D);
        a[J::R_HIP_PITCH]   = clamp_joint(J::R_HIP_PITCH,   q[1]*R2D);
        a[J::R_KNEE_PITCH]  = clamp_joint(J::R_KNEE_PITCH,  q[2]*R2D);
        a[J::R_ANKLE_PITCH] = clamp_joint(J::R_ANKLE_PITCH, q[3]*R2D);
        a[J::R_ANKLE_ROLL]  = clamp_joint(J::R_ANKLE_ROLL,  q[4]*R2D);
    }

    void apply_left(std::array<float,18>& a) const
    {
        constexpr double R2D = 180.0/M_PI;
        const Vec5& q = leg_l_.q;
        a[J::L_HIP_ROLL]    = clamp_joint(J::L_HIP_ROLL,   -q[0]*R2D);
        a[J::L_HIP_PITCH]   = clamp_joint(J::L_HIP_PITCH,   q[1]*R2D);
        a[J::L_KNEE_PITCH]  = clamp_joint(J::L_KNEE_PITCH,  q[2]*R2D);
        a[J::L_ANKLE_PITCH] = clamp_joint(J::L_ANKLE_PITCH, q[3]*R2D);
        a[J::L_ANKLE_ROLL]  = clamp_joint(J::L_ANKLE_ROLL, -q[4]*R2D);
    }

    void tick()
    {
        std::array<float,18> angles;
        for (int i = 0; i < 18; ++i) angles[i] = LIMITS[i].rest;

        if (!get_parameter("enabled").as_bool()) { publish(angles); return; }

        double hip_z = com_z_ - torso_height_ / 2.0;
        Vec3 hip_r = {com_x_, com_y_ + hip_width_/2.0, hip_z};
        Vec3 fr_clamped = {fr_[0], fr_[1], std::max(fr_[2], foot_height_)};
        leg_r_.solve(hip_r, fr_clamped, Q_LO, Q_HI);
        leg_r_.q[3] = std::clamp(-(leg_r_.q[1]+leg_r_.q[2]), Q_LO[3], Q_HI[3]);
        apply_right(angles);
        Vec3 hip_l = {com_x_, com_y_ - hip_width_/2.0, hip_z};
        Vec3 fl_clamped = {fl_[0], fl_[1], std::max(fl_[2], foot_height_)};
        leg_l_.solve(hip_l, fl_clamped, Q_LO, Q_HI);
        leg_l_.q[3] = std::clamp(-(leg_l_.q[1]+leg_l_.q[2]), Q_LO[3], Q_HI[3]);
        apply_left(angles);

        publish(angles);
    }

    void publish(const std::array<float,18>& a)
    {
        std_msgs::msg::Float32MultiArray msg;
        msg.data.assign(a.begin(), a.end());
        joint_pub_->publish(msg);
    }
};

int main(int argc, char** argv)
{
    rclcpp::init(argc, argv);
    rclcpp::spin(std::make_shared<IKVectorsDLS>());
    rclcpp::shutdown();
    return 0;
}
