Allouch-103/Abbes/(commit log)

2026-03-01 modular firmware: raw I2C IMU, servo controller, microros transport
2026-03-01 servos + mpu + micro ros
2026-03-19 balace controller node + config files
    [robot_params.yaml]
2026-04-21 rviz maghir meshes
    [humanoid.urdf.xacro, materials.xacro]
2026-05-05 ros2_control fix
    [controllers.yaml, empty.sdf, humanoid.urdf.xacro]
2026-05-24 Create README.md
    # Robotics & Inverse Kinematics Reference Library
    A curated collection of textbook chapters and research papers covering robot kinematics, trajectory planning, and numerical methods for inverse kinematics.
    ## Contents
    ### 📄 A General, Fast, and Robust Implementation of the Inverse Kinematics
    A research paper presenting a practical IK solver design. Covers a general-purpose approach that balances computational speed with robustness to singularities and unreachable configurations. Useful as an implementation reference.
    ### Manipulator IK – Vectors, Formulas, and Damped Least Squares
    A focused reference on the mathematics of IK for serial manipulators. Cover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
2026-05-25 conception meshes
    [NewL.STL, NewPièce226.STL, Newfoot.SLDPRT.STL, Newleg bracket.STL, NewmainBodyback.SLDPRT.STL, NewmainBodyfront.STL, Newnew_support.STL, Newsecond link.STL]
2026-05-27 ik_vectors_DLS steps explanation
    Added detailed explanations of inverse kinematics solutions using vector formulations and DLS methods.
2026-05-27 Reference Library
    Added a comprehensive reference library for robotics and inverse kinematics, including key papers and recommended reading order.
2026-05-28 Add Wampler DLS IK, joint bridge, walk test script
2026-05-30 feat(description): restructure arm kinematic chain (split shoulder/elbow roll)
    Split shoulder_roll into its own revolute joint via a dummy shoulder_link,
    rework elbow_roll onto the forearm, make the wrist fixed, and widen leg/arm
    joint limits to allow negative angles. Retune wave/bow/march poses in
    pose_definitions to match the new arm chain.
    [humanoid.urdf.xacro]
2026-05-30 feat(ai): safety validator gating LLM commands (AI Step 5)
    Add humanoid_command_api/safety_validator.py: a pure (no-rclpy),
    stateful SafetyValidator.check(name, args, status_provider) consulted
    by the dispatcher between the model's tool choice and execute_tool().
    Three rules:
    - rate limit: deny a motion within min_interval_sec (1.5s) of the last
    - tilt gate (walk only): deny walk if |pitch| or |roll| > 15 deg, read
    lazily via status_provider; fails open when no IMU (server reports 0)
    - stop/get_status exempt: never blocked, don't touch the rate-limit clock
    Wire into llm_dispatcher_node.py: build self.validator in __init__; the
    dispatch() Phase-3 loop now checks before running, and on den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
2026-05-30 feat(ai): feedback loop — agentic recover-then-retry (AI Step 6)
    Turn dispatch() from a fixed two-call exchange into a bounded agentic
    loop (MAX_AGENT_TURNS=5): keep calling the model and running the tools it
    requests, feeding each real robot result back as a role:"tool" message,
    until the model stops requesting tools or the turn cap is hit. Because
    results (incl. denied_by_safety / rejected goals) now land in the
    transcript before the next model call, the model can react — e.g.
    stand_still after a tilt denial then retry walk — instead of only
    narrating the failure. Add a recovery nudge to ROBOT_SYSTEM_PROMPT so the
    model knows it may fix-then-retry on ok:false. Verified offline with a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
2026-05-30 feat(ai): Abbes web UI + fix action-client wait-set crash (AI Step 7)
    - Redesign the browser control panel (web_ui_node.py): Abbes branding,
    animated avatar, live tilt/status dial, capability cards with
    descriptions, chat avatars/timestamps, thinking timer, STOP button.
    - Fix a concurrency crash surfacing as "stupid" robot replies: the
    status-poll emergency node shared the default rclpy context with the
    dispatcher, so concurrent spin_until_future_complete calls corrupted
    the dispatcher's action clients ("wait set index for cancel client is
    out of bounds", action_client.c:650). Give the emergency node its own
    rclpy.Context + SingleThreadedExecutor. Reproduced + fix-verified.
    - T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
2026-05-31 Update project files
    [robot_params.yaml]
2026-06-01 Zc+ angles changed
    [robot_params.yaml]
2026-06-01 Fix IK geometry: hip offset + foot height + matching Z_C
    [ik_vectors_DLS.cpp]
